BenGardiner/RAMN/docs/hardware/Fabrication/img/wrong_r.jpg

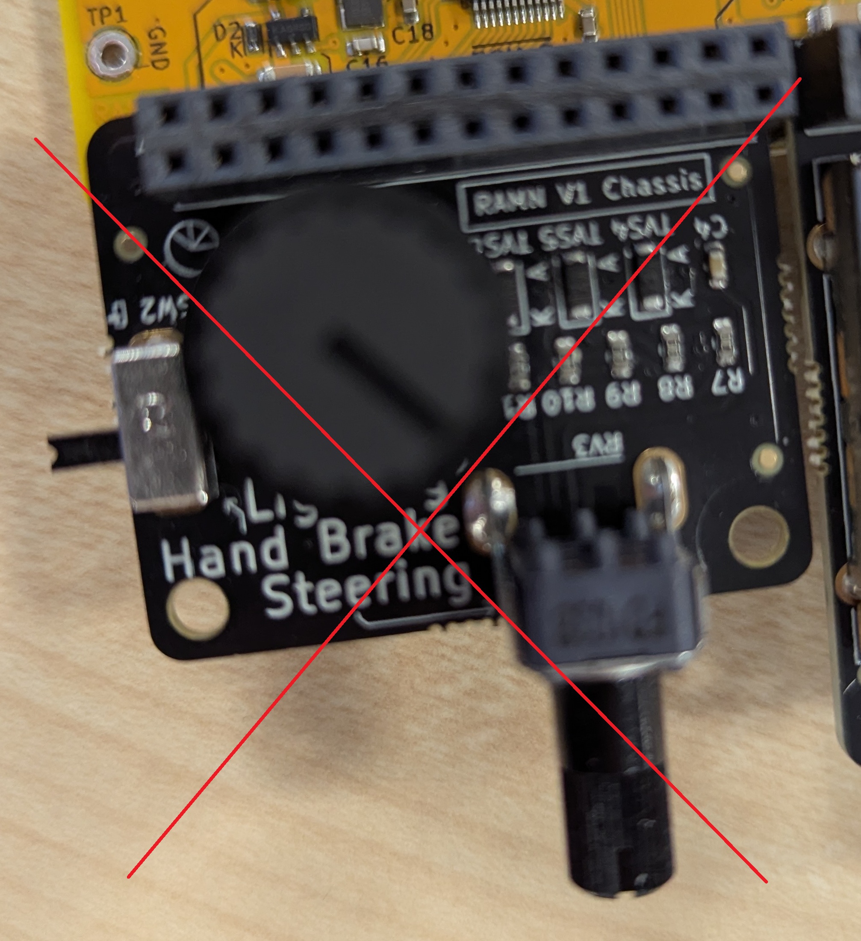
docs/hardware/Fabrication/img/wrong_r.jpg
