BenGardiner/RAMN/docs/hardware/Fabrication/img/correct_l.jpg

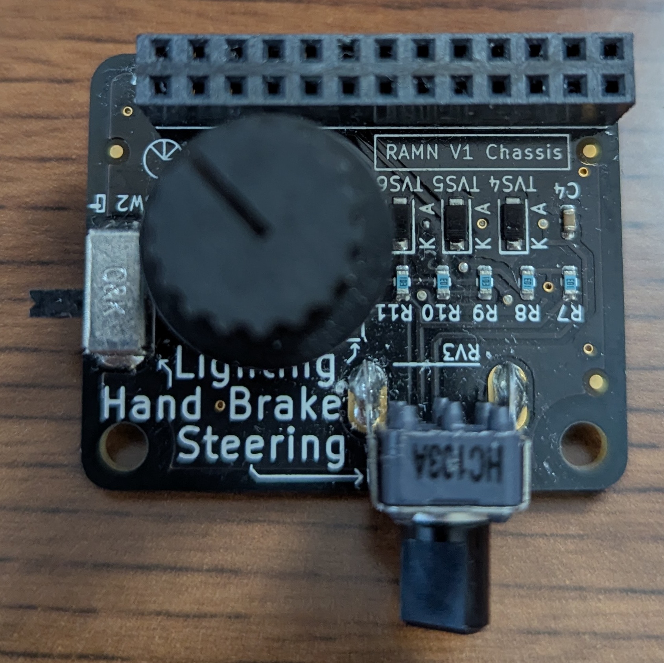
docs/hardware/Fabrication/img/correct_l.jpg
