BenGardiner/RAMN/docs/hardware/Fabrication/img/correct_o.jpg

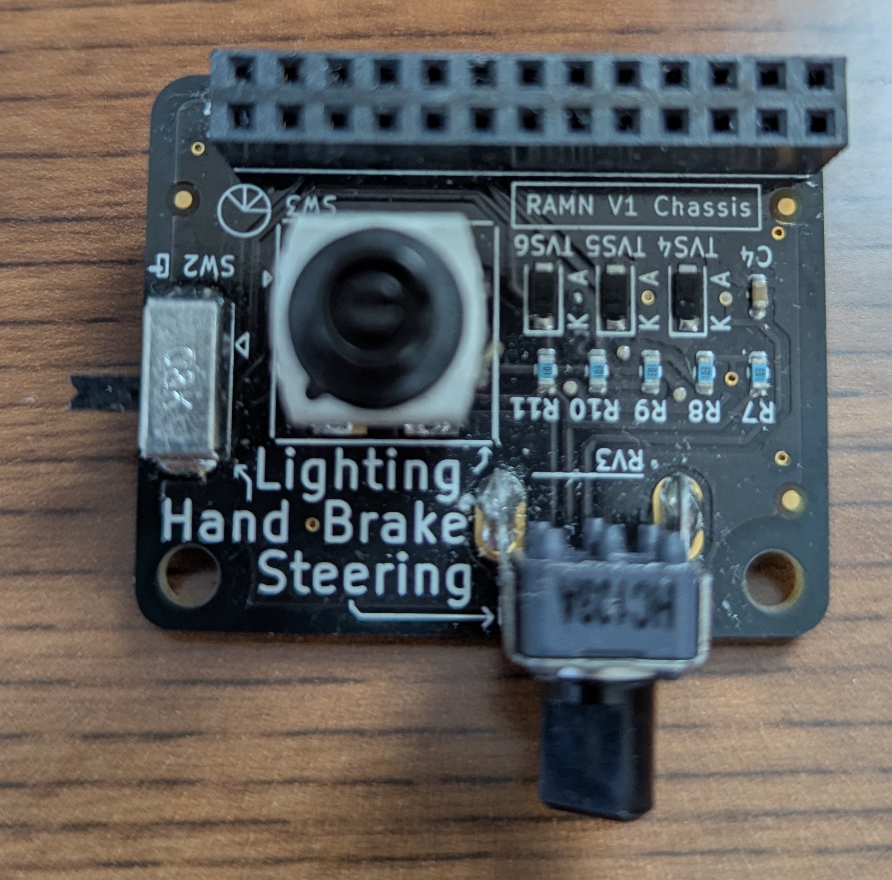
docs/hardware/Fabrication/img/correct_o.jpg
