BenGardiner/RAMN/docs/hardware/Fabrication/img/correct_r.jpg

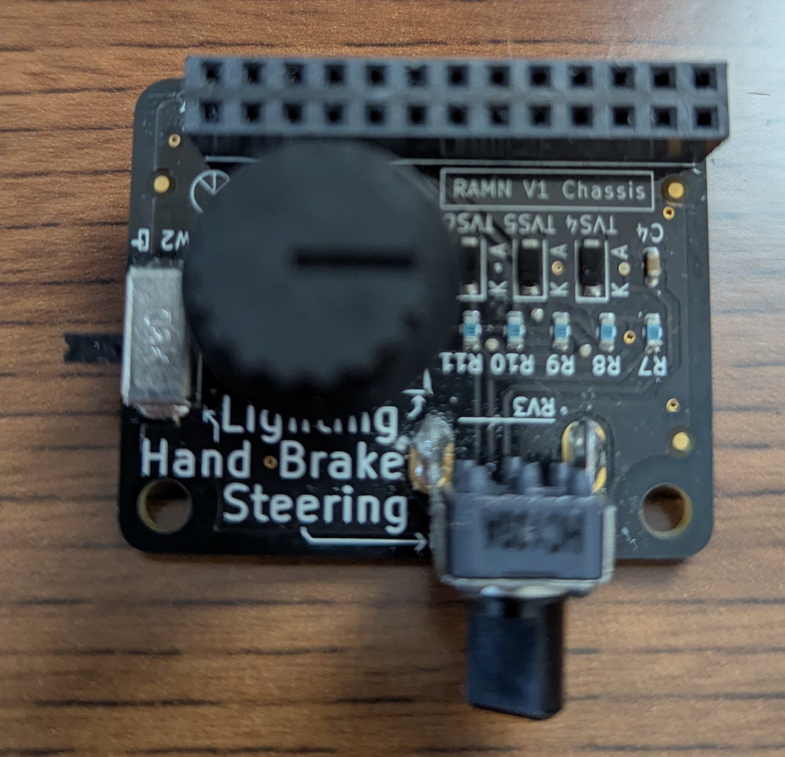
docs/hardware/Fabrication/img/correct_r.jpg
