BenGardiner/RAMN/docs/hardware/Fabrication/img/wrong_l.jpg

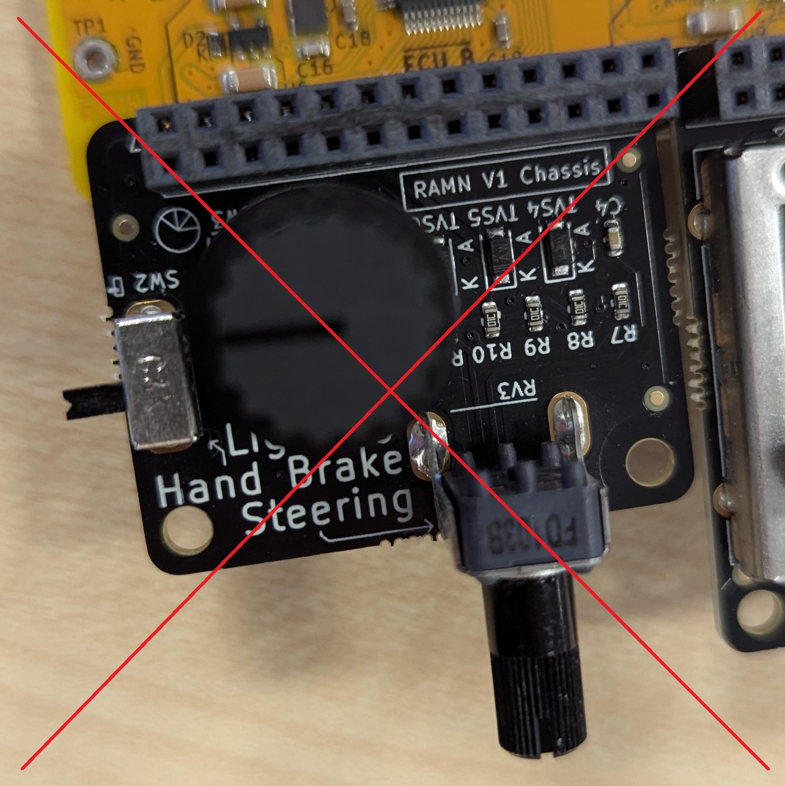
docs/hardware/Fabrication/img/wrong_l.jpg
