BenGardiner/RAMN/docs/hardware/Fabrication/img/wrong_o.jpg

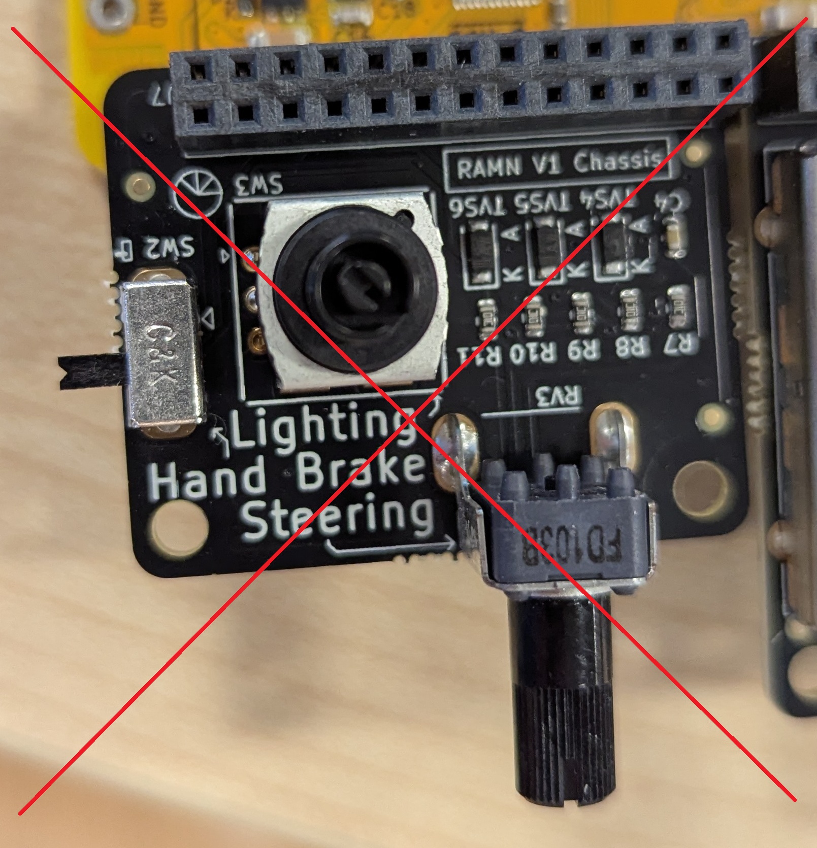
docs/hardware/Fabrication/img/wrong_o.jpg
