BenGardiner/RAMN/firmware/RAMNV1/Core/Inc/ramn_spi.h

/*
 * ramn_spi.h
  ******************************************************************************
  * @attention
  *
  * <h2><center>&copy; Copyright (c) 2025 TOYOTA MOTOR CORPORATION.
  * ALL RIGHTS RESERVED.</center></h2>
  *
  * This software component is licensed by TOYOTA MOTOR CORPORATION under BSD 3-Clause license,
  * the "License"; You may not use this file except in compliance with the
  * License. You may obtain a copy of the License at:
  *                        opensource.org/licenses/BSD-3-Clause
  *
  ******************************************************************************
 */

// This Module handles SPI communication, with the LCD Screen (ECU A) or the LEDs (ECU D)

#ifndef INC_RAMN_SPI_H_
#define INC_RAMN_SPI_H_

#include "main.h"
#include "cmsis_os.h"
#ifdef ENABLE_SCREEN
#include "fonts.h"
#include "ramn_usb.h"
#include "ramn_canfd.h"
#include "ramn_trng.h"

// Below are definitions for ST7789 Chipset screen
#define ST7789_CASET 0x2A
#define ST7789_RASET 0x2B
#define ST7789_MADCTL 0x36
#define ST7789_RAMWR 0x2C
#define ST7789_RAMRD 0x2E
#define ST7789_COLMOD 0x3A
#define ST7789_INVON  0x21
#define ST7789_SPLOUT 0x11
#define ST7789_SWRESET 0x01
#define ST7789_NORON 0x13
#define ST7789_DISPON 0x29
#define ST7789_RAMCTRL 0xB0
#define ST7789_SPI2EN 0xE7
#define ST7789_VSCRDEF 0x33
#define ST7789_VSCSAD 0x37

#define LCD_WIDTH 240
#define LCD_HEIGHT 240
//#define LCD_HEIGHT 320
#define SCROLL_WINDOW_HEIGHT 320 // Even 240x240 screens have a scrolling window of 320 pixels in RAM
#define SCREEN_HEADER_SIZE 32 // Size of header displayed when scrolling
#define SCREEN_FOOTER_SIZE 0 // Size of footer displayed when scrolling
#define SCROLL_AREA_SIZE (SCROLL_WINDOW_HEIGHT-(SCREEN_HEADER_SIZE+SCREEN_FOOTER_SIZE))

// Colors must be in RGB565 format.
#define COLOR_BLACK 0x0000
#define COLOR_WHITE 0xFFFF
#define COLOR_RED 0xF800
#define COLOR_GREEN 0x07E0
#define COLOR_BLUE 0x001F

#endif

#ifdef ENABLE_SPI

// Initializes the Module.
void 	RAMN_SPI_Init(SPI_HandleTypeDef* handler, osThreadId_t* pTask);

#endif

#ifdef ENABLE_SCREEN
// Initializes the screen and turn it ON.
void 	RAMN_SPI_InitScreen(void);

// Sets the current screen scroll.
void 	RAMN_SPI_SetScroll(uint16_t val);

// Increases the current screen scroll.
void 	RAMN_SPI_ScrollUp(uint16_t addVal);

// Draws the value of a specific pixel on the screen.
void 	RAMN_SPI_DrawPixel(uint16_t x, uint16_t y, uint16_t color);

// Draws a rectangle of the specified color on the screen.
void 	RAMN_SPI_DrawRectangle(uint16_t startx, uint16_t starty, uint16_t w, uint16_t h,uint16_t color);

// Draws a contour (empty rectangle).
void 	RAMN_SPI_DrawContour(uint16_t startx, uint16_t starty, uint16_t endx, uint16_t endy, uint16_t width, uint16_t color);

// Draws a 565 color image from specified array (Little Endian).
void 	RAMN_SPI_DrawImage(uint16_t x, uint16_t y, uint16_t w, uint16_t h, const uint8_t* image);

// Draws ONE character with specified background/foreground color.
void 	RAMN_SPI_DrawChar(uint16_t x, uint16_t y, uint16_t fgColor, uint16_t bgColor, uint8_t chr);

// Draws a character WITHOUT spacing (for overwriting a string, this function assumes the background is already drawn).
void 	RAMN_SPI_RefreshChar(uint16_t x, uint16_t y, uint16_t fgColor, uint16_t bgColor, uint8_t chr);

// Draws specified zero-terminated string with specified background/foreground color. \n and \r treated as newLines.
void 	RAMN_SPI_DrawString(uint16_t x, uint16_t y, uint16_t fgColor, uint16_t bgColor, const char* src);

// Same as RAMN_SPI_RefreshChar but with strings.
void 	RAMN_SPI_RefreshString(uint16_t x, uint16_t y, uint16_t fgColor, uint16_t bgColor, const char* src);

// Same as RAMN_SPI_DrawString/RAMN_SPI_RefreshString  but using uint32_t as argument. Displays in hex by default (without leading 0x)
void 	RAMN_SPI_DrawUint32(uint16_t x, uint16_t y, uint16_t fgColor, uint16_t bgColor, uint32_t val);
void 	RAMN_SPI_RefreshUint32(uint16_t x, uint16_t y, uint16_t fgColor, uint16_t bgColor, uint32_t val);



#endif

#if defined(EXPANSION_BODY) && defined(ENABLE_SPI)
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
