BenGardiner/RAMN/(commit log)

2025-11-12 clarified lighting switch orientation with pictures; updated documentation.
2026-02-28 Fix all compiler warnings across ECUA/B/C/D firmware targets (#3)
    * Fix all compiler warnings across ECUA, ECUB, ECUC, ECUD targets
    - ramn_j1979.c: Add #include <string.h> for memset/strcpy, initialize loop variable i
    - ramn_uds.c: Add #include <string.h> for strcpy/strcmp, fix incompatible pointer type cast, add (const uint8_t*) casts for FLAG macros
    - ramn_ctf.c: Add #include <string.h> for memcmp
    - ramn_spi.c: Move SPI DMA functions from ENABLE_SPI to ENABLE_SCREEN guard to avoid unused-function warnings
    - ramn_screen_canlog.c: Add explicit casts to resolve discarded volatile qualifier warnings
    - usbd_gs_usb.c: Move forward declaration and gscan_dconf inside #ifdef ENABLE_GSUSB
    Co-autho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
    [ramn_ctf.c, ramn_j1979.c, ramn_screen_canlog.c, ramn_spi.c, ramn_uds.c]
2026-02-28 Fix SLCAN TX interleaving: hold USB TX lock across ack + CAN send (#1)
    * Fix SLCAN write ordering bug: send '\r' ack before queuing CAN frame
    Move the '\r' acknowledgment to before RAMN_FDCAN_SendMessage() for both
    standard ID ('t'/'r') and extended ID ('T'/'R') transmit commands. This
    prevents a race condition where the CAN RX task could write a 't' start-of-frame
    before the '\r' ack from the transmit command, since RAMN_FDCAN_SendMessage
    queues the frame which may be received and forwarded by the CAN RX task
    before the USB ack is sent.
    Also consolidate the 'N' serial number response to include '\r' in a
    single atomic USB send, preventing similar interleaving.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
    [ramn_cdc.c, ramn_usb.c, ramn_usb.h]
2026-03-04 Fix STM32 HAL USB PCD concurrency bug by adding IRQ-safe critical sections
    Add HAL_NVIC_DisableIRQ(USB_FS_IRQn) / HAL_NVIC_EnableIRQ(USB_FS_IRQn) around
    __HAL_LOCK/__HAL_UNLOCK in HAL_PCD_EP_Receive() and HAL_PCD_EP_Transmit() to
    prevent USB interrupt preemption during endpoint configuration, which caused
    USBD_BUSY deadlocks on aggressive xHCI host controllers.
2026-03-04 Handle lock failure edge case: re-enable IRQ before returning HAL_BUSY
    Replace __HAL_LOCK/__HAL_UNLOCK macros with manual lock check to ensure
    HAL_NVIC_EnableIRQ is always called, even if the lock is already held.
2026-03-04 Move USB concurrency fix to usbd_conf.c with USER CODE block protection
    Revert stm32l5xx_hal_pcd.c to its original state since HAL driver files
    are overwritten by STM32CubeMX firmware package updates.
    Instead, apply the IRQ disable/enable protection at the application level
    in usbd_conf.c around HAL_PCD_EP_Transmit() and HAL_PCD_EP_Receive() calls,
    wrapped in USER CODE BEGIN/END block comments to survive CubeMX regeneration.
2026-03-04 Fix USB PCD concurrency: add __HAL_LOCK with IRQ critical sections in HAL driver
    Applies the proven fix from the ST community thread:
    - Add HAL_NVIC_DisableIRQ(USB_FS_IRQn) before __HAL_LOCK(hpcd)
    - Add HAL_NVIC_EnableIRQ(USB_FS_IRQn) after __HAL_UNLOCK(hpcd)
    in both HAL_PCD_EP_Receive() and HAL_PCD_EP_Transmit().
    Reverts previous incorrect approach that wrapped calls in usbd_conf.c.
    Changes marked with USER CODE BEGIN/END comments per CubeMX convention.
2026-03-05 Fix EP2 OUT descriptor: wMaxPacketSize 128->64 for Full-Speed USB compliance
    The OUT endpoint 2 descriptor used GSUSB_RX_DATA_SIZE (128 bytes) for
    wMaxPacketSize, which is invalid per USB 2.0 §5.8.3 (Full-Speed bulk
    endpoints must use 8, 16, 32, or 64 bytes). AMD xHCI controllers strictly
    enforce this and reject the device.
    Changed to CAN_DATA_MAX_PACKET_SIZE (64), matching the actual endpoint
    configuration in usbd_gs_usb.c which already opens EP2 OUT with 64 bytes.
    The GSUSB_RX_DATA_SIZE (128) is preserved for the receive buffer and
    PrepareReceive calls, which can safely exceed the endpoint max packet size.
2026-03-06 STALL unhandled USB control requests in composite Setup handler
    Return USBD_FAIL in USBD_Composite_Setup default case so that
    USBD_CtlError properly STALLs EP0 for unrecognized interface
    requests. Previously the handler silently returned USBD_OK without
    sending any USB response, causing Windows hosts to hang on
    enumeration (Code 43).
    This ensures protocol-compliant negative acknowledgment for:
    - Microsoft-specific vendor requests (URB_FUNCTION_GET_MS_FEATURE_DESCRIPTOR)
    - Any control request targeting an unknown interface index
2026-03-06 Port USB STALL and descriptor fixes from reference firmware
    Port changes from BenGardiner/ucan_cantact_fw commits 8611dd5 and
    7b36380 for Windows and AMD xHCI USB host compatibility:
    1. USBD_GSUSB_Setup: STALL unknown standard requests and request
    types instead of silently returning OK (separate SET_INTERFACE
    from default case)
    2. USBD_GSUSB_CustomDeviceRequest: STALL unmatched vendor code
    requests with USBD_CtlError instead of falling through to
    USBD_LL_SetupStage dispatch
    3. IAD bInterfaceCount: 0x02 → 0x01 (DFU has class 0xFE, not
    vendor-specific 0xFF, so must not be grouped with GS_USB)
    4. MS Compatible ID Feature Descriptor: remove DFU section,
    update length 0x40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
2026-03-06 Add WARNING comments for AMD xHCI USB compatibility
    Port documentation comments from reference commit 46dd094:
    - Device Qualifier Descriptor NULL callback hard-fault risk
    - IAD bInterfaceCount=1 requirement for AMD xHCI
    - EP2 wMaxPacketSize <=64 Full Speed bulk requirement
    - MS Compatible ID single WINUSB section requirement
    - STALL handlers required for Windows enumeration
    - Device class triad 0xEF/0x02/0x01 for IAD
    - Updated HAL PCD concurrency fix comment style
    - Config descriptor size breakdown comments
2026-03-06 Fix DFU interface Code 28 confusion in Device Manager
    The device showing Code 28 "no driver" in Windows Device Manager is the
    DFU interface (interface 1), NOT the gs_usb interface (interface 0).
    The gs_usb interface works correctly via WinUSB.
    - Rename DFU interface string: "RAMN gs_usb interface" → "RAMN DFU interface"
    so Device Manager clearly shows which interface has Code 28
    - Add WARNING comment explaining Code 28 is expected for the DFU runtime
    interface (Windows has no built-in DFU driver)
    - Fix bInterfaceClass comment: 0xFE is Application Specific (DFU), not
    Vendor Specific (0xFF)
    [ramn_config.h]
2026-03-06 Remove non-functional DFU interface to fix Windows Code 28 warning
    The DFU interface (interface 1) was a vestigial descriptor inherited from
    the candlelight gs_usb reference design. RAMN does not implement USB DFU
    protocol — it uses the STM32 bootloader via a CDC serial command instead.
    The non-functional DFU interface caused Code 28 "no driver" in Windows
    Device Manager.
    - Remove DFU interface descriptor and DFU functional descriptor (18 bytes)
    - Remove gsusb_dfu_request function and gsusb_vendor_request dispatcher
    - Remove DFU_INTERFACE_NUM, DFU_INTERFACE_STR_INDEX, dfu_detach_requested
    - Update descriptor sizes: 124→106 (CDC+GSUSB), 58→40 (GSUSB-only)
    - Update interface counts: 4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
    [ramn_config.h]
2026-03-06 Change USB product string from "RAMN USB Composite Device" to "RAMN gs_usb Device"
2026-03-06 build: be quiet unless there's a problem
    command line builds just print the 4x 'build done 0 errors, 0 warnings'
    lines (one for each ECU)
    CI builds are still noisy
2026-03-07 centralize and test the current signal serdes
2026-03-07 fix left and right turn signals
    [ramn_can_database.c, test_serdes_roundtrip.py]
2026-03-07 fix dump screen header ON/STOP alignment
    [ramn_screen_canlog.c]
2026-03-10 fix periods to be J1939 standards compliant (but as fast as possible)
    [ramn_vehicle_specific.h]
2026-03-16 Add J1939 CA scanner with multi-method detection tracking
    Create RAMN_J1939_Scanner.py implementing j1939_scan() that:
    - Probes CAN bus using four techniques (addr_claim, ecu_id, unicast, rts_probe)
    - Accumulates all detection methods per SA (never overwrites)
    - Returns sorted list of (sa, detections) tuples
    Add test_j1939_scanner.py with 11 tests validating scanner behavior.
2026-03-16 Add UDS (Tester Present) as 5th J1939 scan technique
    - Add PF_DIAG=0xDA constant and UDS_TESTER_PRESENT_REQ/RESP constants
    - Add _scan_uds() function that probes each DA with Tester Present
    (SID=0x3E) and records SAs that return positive response (0x7E)
    - Wire _scan_uds() into j1939_scan() as 5th technique
    - Update tests: TestAllFiveTechniquesOnAllECUs, TestUdsScanDetection,
    TestUdsScanner protocol tests
    - All 43 tests pass (15 scanner + 28 protocol)
2026-03-17 Fix UDS scan response matching and add rate limiting with bitrate extraction
    - Fix UDS scan to use prefix comparison (data[:3]) instead of exact match,
    so padded CAN frames (8-byte with 0xFF/0x00 padding) are detected
    - Add _inter_probe_delay() for rate-limiting per-DA scan loops
    - Add _get_bitrate() to extract bitrate from CANSocket/Bus objects
    - Wire rate limiting into unicast, rts_probe, and uds scan techniques
    - Add bitrate/busload parameters to j1939_scan() public API
    - When bitrate=None, scanner reads sock.bitrate; falls back to 250000
    - Add tests for padded UDS responses, rate-limiting, bitrate extraction
    [RAMN_J1939_Scanner.py, test_j1939_scanner.py]
2026-03-17 Extract CAN_FRAME_OVERHEAD_BITS constant from magic number 47
    Replace magic number 47 in _inter_probe_delay() with named constant
    CAN_FRAME_OVERHEAD_BITS for self-documenting rate-limit calculation.
    [RAMN_J1939_Scanner.py]
2026-03-22 fix warnings in bitbanging stuff
    [ramn_bitbang.c, ramn_cdc.c]
2026-03-22 Add compile-time forced autopilot/fuzzer mode and safe program_BCD scripts
    - Add RAMN_FORCE_AUTOPILOT macro to ramn_config.h (commented out by default)
    - Add forced autopilot code path in ramn_simulator.c that randomizes
    command/control values at 1 Hz using TRNG, bypassing sensor overrides
    - Include ramn_trng.h conditionally in ramn_simulator.h
    - Add disable_autopilot.py helper script for safe flashing
    - Update ProgramECU_BCD.sh and .bat to disable autopilot before flashing
2026-04-08 add macro guards for variant build compatibility
    - ramn_config.h: Replace UART+CDC #error with #undef ENABLE_UART
    (auto-disable UART when CDC is active on ECU A)
    - ramn_config.h: Add KWP/XCP buffer sizes for ECU A behind
    ENABLE_KWP/ENABLE_XCP guards
    - main.c: Fix KWP TX buffer using wrong size macro
    (KWP_ISOTP_RX_BUFFER_SIZE -> KWP_ISOTP_TX_BUFFER_SIZE)
    - ramn_spi.c/h, ramn_actuators.c: Add ENABLE_SPI guard to
    RAMN_SPI_UpdateLED definition and call sites
    Agent-Logs-Url: https://github.com/BenGardiner/RAMN/sessions/1f1ef303-fbc5-4893-a129-e76bc35aebae
    [main.c, ramn_actuators.c, ramn_config.h, ramn_spi.c, ramn_spi.h]
2026-04-08 fix KWP_TX_CANID typo and reduce ECU A KWP buffer sizes
    - ramn_vehicle_specific.h: Fix typo KWP_TX_CANID referencing itself
    instead of KWP_RX_CANID for ECU A
    - ramn_config.h: Use smaller KWP buffer sizes for ECU A (0xFFF+2)
    to match UDS buffer pattern and fit in available RAM
    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
    [ramn_vehicle_specific.h]
2026-04-08 uart variant: disable CDC+USB instead of #undef UART, restore #error
    The uart variant now disables ENABLE_CDC and ENABLE_USB rather than
    silently undefining ENABLE_UART. The original #error for UART+CDC
    conflict is restored in ramn_config.h.
    Agent-Logs-Url: https://github.com/BenGardiner/RAMN/sessions/903e16fd-21c8-4ff7-a0f2-56a7d76238ed
    [ramn_config.h]
2026-04-08 reduce ECU A KWP buffer sizes to 0xFFF+2 to fix INSECURE_RAM overflow
    Agent-Logs-Url: https://github.com/BenGardiner/RAMN/sessions/3a274ba1-e0a1-4176-b9ae-4be7307cdbdf
    [ramn_config.h]
2026-04-11 Add SUMP/OLS logic analyzer mode for CAN TX/RX pin monitoring via PulseView
    - Create ramn_sump.h with SUMP protocol constants and API
    - Create ramn_sump.c with full SUMP state machine, GPIO sampling, and command processing
    - Add ENABLE_SUMP_OLS macro to ramn_config.h (enabled for ECU A)
    - Add 'sump' CLI command to ramn_cdc.c
    - Add SUMP help text to CLI help
    - Add config validation (requires ENABLE_BITBANG and ENABLE_CDC)
    - Add sump_ols variant to build workflow matrix
    Agent-Logs-Url: https://github.com/BenGardiner/RAMN/sessions/7243963c-7631-4e38-924f-61c9f24b834b
2026-04-11 Add SUMP protocol unit tests (57 tests, all passing)
    Test coverage includes:
    - Protocol constants validation
    - ID and metadata response format
    - Reset, divider, count, flags commands
    - Trigger mask/value for all 4 stages
    - ESC exit mechanism
    - Sample format for CAN TX/RX pins
    - PulseView handshake sequence simulation
    - Config guard verification
    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
    [test_sump_protocol.py]
2026-04-11 Fix SUMP enter loop drain logic, remove unused variable
    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
    [ramn_sump.c]
2026-04-11 SUMP auto-detect from PulseView + bitbang capture integration + tests
    Major changes:
    - SUMP_RUN now returns pre-recorded bitbang samples instead of live capture
    - All bitbang operations (Read, Dump, Send, Jam, LoopOF, DenyOnce) record TX+RX
    pin samples into shared SUMP buffer via RAMN_SUMP_RecordSample()
    - CDC ISR forwards binary control bytes (< 0x20) immediately when buffer is empty
    - SLCAN handler auto-detects SUMP_ID (0x02) probe and enters SUMP mode
    - 82 unit tests (25 new) covering auto-detect, capture, CDC forwarding
    Agent-Logs-Url: https://github.com/BenGardiner/RAMN/sessions/52ac2678-d68a-4b76-99bc-8fbc92b07436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
    [test_sump_protocol.py]
2026-04-11 Add SUMP pre/post trigger windowing, circular buffer, and trigger channel
    - Convert sample buffer to circular (power-of-2 masked) for continuous capture
    - Add RAMN_SUMP_TriggerIndex to track bitbang trigger position
    - Add SUMP_BIT_TRIG (bit 2) as channel 2 visible in PulseView
    - Add RAMN_SUMP_MarkTrigger() / BB_SUMP_MARK_TRIGGER() macro
    - Window SUMP_RUN output around trigger using SUMP CNT delay_count
    - Add BB_SUMP_MARK_TRIGGER() after successful Trigger() in all bitbang ops
    - Increase SUMP_NUM_PROBES to 3 (TX, RX, TRIG)
    - 97 tests pass (15 new tests for windowing, trigger, circular buffer)
    Agent-Logs-Url: https://github.com/BenGardiner/RAMN/sessions/0f0257f3-8c36-45ed-98c4-f6561a5d5826
    C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
2026-04-11 Add SUMP/OLS logic analyzer documentation to bitbang section
    Document entry (CLI 'sump' command and PulseView auto-detection),
    3-channel capture (CAN_TX, CAN_RX, TRIG), typical workflow with bb
    commands, pre/post trigger windowing, and clean ESC exit mechanism.
    Agent-Logs-Url: https://github.com/BenGardiner/RAMN/sessions/7642e56a-da5b-479c-aaa7-224568b9471b
2026-04-11 Add bb gsusb command: GS_USB + bitbang bridge mode
    Implements a new 'bb gsusb' CLI command that bridges the GS_USB
    (candlelight) interface with the bitbang module. CAN frames received
    via bitbang are delivered to the host through GS_USB, and frames sent
    by the host are transmitted using GPIO bitbanging.
    Includes:
    - BB_BuildFrameBitstream(): builds complete CAN frame with stuffing/CRC
    - BB_ParseFrameFields(): extracts frame fields from destuffed capture
    - RAMN_BITBANG_GsUsbLoop(): main bridge loop with ESC exit
    - Documentation in protocol_tutorial.rst
    Agent-Logs-Url: https://github.com/BenGardiner/RAMN/sessions/6490a94d-b88c-4b3b-adc7-947176e46262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
2026-04-11 Add RAMN_GSUSB_BBMode flag: GS_USB only uses bb after CLI command
    The FDCAN RX callback in main.c now checks RAMN_GSUSB_BBMode before
    forwarding frames to GS_USB. The flag is False by default (normal
    FDCAN-based GS_USB operations). The 'bb gsusb' CLI command sets it
    before BB_Start() and clears it after BB_Stop(), ensuring clean
    transitions between normal and bb modes.
    Agent-Logs-Url: https://github.com/BenGardiner/RAMN/sessions/683d17c4-b35c-4c99-8b22-1abb8a850349
2026-04-11 Preserve bb mode on ESC exit from bb gsusb loop
    ESC now exits the active bitbang+GS_USB loop but does NOT clear
    RAMN_GSUSB_BBMode. The flag persists so FDCAN RX is not forwarded
    to GS_USB after exiting. The user can re-enter 'bb gsusb' to
    resume the bridge.
    Agent-Logs-Url: https://github.com/BenGardiner/RAMN/sessions/a0db99b4-56f7-48c6-9d00-43674b329d0c
2026-04-11 Revert 'Preserve bb mode on ESC exit from bb gsusb loop'
    Restores RAMN_GSUSB_BBMode = False on ESC exit so normal GS_USB
    operations resume when leaving the bb gsusb loop.
    Agent-Logs-Url: https://github.com/BenGardiner/RAMN/sessions/97dab172-332c-4b4e-a058-78f2d220f83c
    [ramn_bitbang.c, ramn_gsusb.h]
2026-04-11 Document user flow: bitbang, SUMP, and GS_USB combined workflow
    Add 'Combined Workflow' section to protocol_tutorial.rst documenting:
    - GS_USB behavior at each stage (normal, bb commands, bb gsusb, sump)
    - Full iterative debugging workflow (trigger → capture → PulseView → repeat)
    - GS_USB bridge workflow with SUMP
    - Clarify RAMN_GSUSB_BBMode lifecycle in header comment
    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
2026-04-11 Add SUMP auto-enter from bb gsusb mode (PulseView 0x02 probe detection)
    When in bb gsusb mode, RAMN now detects PulseView's SUMP probe byte
    (0x02) in the USB stream. On detection, the bb gsusb loop pauses,
    enters SUMP mode to serve pre-recorded samples, and resumes when
    SUMP exits (ESC). ESC outside SUMP still exits bb gsusb entirely.
    New BB_CheckForEscOrSUMP() function returns a tri-state result
    (NONE/ESC/SUMP) to support both behaviors in the same loop.
    Guarded by ENABLE_SUMP_OLS && ENABLE_GSUSB.
    Agent-Logs-Url: https://github.com/BenGardiner/RAMN/sessions/14d131c5-9a46-4339-b20c-e40bb7e06cd8
2026-04-11 SUMP: auto-capture on RUN, RLE compression with 1M window, CLI auto-detect
    1. SUMP_RUN auto-captures (calls RAMN_BITBANG_Read) when no samples exist
    2. RLE compression: report 1M window to PulseView, compress identical
    consecutive samples with SUMP RLE encoding when SUMP_FLAG_RLE is set
    3. SUMP auto-detect (PulseView 0x02 probe) now works in CLI mode too,
    not just SLCAN mode - added check in RAMN_CDC_ProcessCLIBuffer
    4. FLAGS handler now parses all 4 parameter bytes (needed for RLE bit 8)
    5. Updated tests: 116 tests (was 97), all passing
    Agent-Logs-Url: https://github.com/BenGardiner/RAMN/sessions/514bba00-aa80-4b1a-ad99-0d5b73c947f8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
2026-04-11 fix: use silent bitbang capture for SUMP auto-capture (no USB text)
    SUMP_RUN now calls RAMN_BITBANG_ReadSilent() instead of RAMN_BITBANG_Read()
    when auto-capturing on first PulseView run. The silent version captures
    samples into the SUMP buffer without sending any human-readable text
    (Raw/Destuffed/CAN annotations) to USB, which was corrupting PulseView's
    binary SUMP data stream and causing no samples to be visible.
    Agent-Logs-Url: https://github.com/BenGardiner/RAMN/sessions/f6a18ca6-ede4-45ca-830c-f6269dc7c807
    [ramn_bitbang.c, ramn_bitbang.h, ramn_sump.c, test_sump_protocol.py]
2026-04-11 fix: SUMP CDC raw forwarding, remove dangerous auto-capture, fix delay_count +1
    Root cause: CDC ISR only forwarded control bytes (<0x20) as SUMP commands.
    PulseView's binary long commands (FLAGS 0x82, CNT 0x81, trigger 0xC0+)
    got stuck in the CDC line buffer since they're >=0x20 and no \r follows.
    Fix: Add RAMN_SUMP_Active flag checked by CDC ISR. When True (inside
    SUMP_Enter), ALL received USB bytes are forwarded raw to the stream
    buffer, bypassing line-buffering entirely. This lets PulseView's full
    command sequence (config + RUN) reach the SUMP state machine.
    Also:
    - Remove ReadSilent auto-capture from SUMP_RUN: it blocked with IRQs
    disabled and could hang forever after bb jam (BB_Wait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
    [ramn_bitbang.c, ramn_bitbang.h, ramn_sump.c, ramn_sump.h, test_sump_protocol.py]
2026-04-11 fix: SUMP sample width respects FLAGS channel group mask for PulseView compatibility
    PulseView disables channel groups 2-4 via SUMP FLAGS for 3-channel devices,
    expecting 1-byte-per-sample output. Previously we always sent 4 bytes per
    sample, causing PulseView to misinterpret data ("no data" visible).
    Changes:
    - Add sample_width to SUMP_Config_t, computed from FLAGS channel group bits
    - SUMP_EmitSample sends only sample_width bytes (1-4) per sample
    - SUMP_EmitRLECount uses sample_width bytes with correct max count
    - RLE encoding splits counts at sample_width-dependent maximum
    (127 for 1-byte, 32767 for 2-byte, etc.)
    - Add SUMP_FLAG_CHANGRP_1-4 constants to ramn_sump.h
    - Add 14 new tests f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
    [ramn_sump.c, ramn_sump.h, test_sump_protocol.py]
2026-04-11 fix: handle OLS separate read/delay count commands 0x83/0x84
    The sigrok OLS driver sends SUMP_READCOUNT (0x84) and SUMP_DELAYCOUNT
    (0x83) as separate commands instead of the combined SUMP_CNT (0x81).
    Without handling these, read_count and delay_count stayed at their huge
    defaults (1M), causing the firmware to send far more samples than
    PulseView expected — resulting in timeout and "no data" displayed.
    - Add SUMP_READCOUNT (0x84) and SUMP_DELAYCOUNT (0x83) constants
    - Handle both in SUMP_ProcessCommand with same encoding as SUMP_CNT
    - Add 10 new tests including sigrok-cli exact sequence reproduction
    - All 144 tests pass, firmware builds clean (0 errors, 0 warnings)
    Agent-Logs-Url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
    [ramn_sump.c, ramn_sump.h, test_sump_protocol.py]
2026-04-12 fix: bb vcd uses all available samples and compact one-line header
    The previous implementation ended the VCD window at the trigger point,
    but most bitbang commands (like denyonce) record the trigger marker
    before the interesting data. This meant the VCD showed zero signal
    changes.
    Now the VCD uses all available samples in the circular buffer (up to
    4096), giving the maximum possible window. The header is also emitted
    as a single line for maximum compactness.
    Agent-Logs-Url: https://github.com/BenGardiner/RAMN/sessions/45e44c42-e801-4637-b9ce-0f39b626164e
    [ramn_bitbang.c, ramn_bitbang.h]
2026-04-13 fix: SUMP ISR race condition and send error detection
    When PulseView sends SUMP commands batched in the same USB packet
    as the SUMP_ID probe (0x02), long commands (FLAGS 0x82, CNT 0x81)
    would get stuck in the CDC line buffer because they are >= 0x20.
    Fix: When SUMP_ID is detected in the CDC ISR, immediately set
    RAMN_SUMP_Active=True and forward all remaining bytes in the
    current USB packet raw. This ensures long SUMP commands reach
    the SUMP processor regardless of USB packet batching.
    Also add send error detection in SUMP send helpers so the device
    aborts quickly if the USB host disconnects mid-transfer instead
    of blocking for 2s per failed xStreamBufferSend call."
    Agent-Logs-Url: https:/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
    [ramn_sump.c]
2026-04-13 fix: flush USB TX pipeline on SUMP session boundaries to prevent stale data de-sync
    When the serial port is closed while CLI output (e.g. "Denying..." from
    bb denyonce) or SUMP sample data is still in the USB TX pipeline, stale
    bytes can survive in the USB PMA endpoint buffer. When sigrok-cli reopens
    the port and sends SUMP_ID, it reads these stale bytes instead of "1ALS",
    causing "Invalid reply" errors.
    Fix:
    - Add RAMN_USB_FlushTxPipeline() which suspends the TX task, resets the
    TX stream buffer, then resumes the TX task.
    - Call it on every SUMP_RESET and SUMP_ID, and before the initial "1ALS"
    response in all auto-detect paths (CLI, SLCAN, gsusb).
    - In SerialCloseCallback, NAK the CDC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
    [ramn_bitbang.c, ramn_cdc.c, ramn_sump.c, ramn_usb.c, ramn_usb.h]
2026-04-15 feat: RLE-compressed SUMP storage with dynamic metadata for sample count and rate
    Agent-Logs-Url: https://github.com/BenGardiner/RAMN/sessions/7520d072-d3de-4176-ac10-54d580c3afc9
2026-04-15 fix: VCD uses stored sample rate, bb gsusb accumulates SUMP samples across session, VCD emits final timestamp
    Agent-Logs-Url: https://github.com/BenGardiner/RAMN/sessions/9e5cb2a0-8f5c-4a22-adf9-4e804994df32
    [ramn_bitbang.c]
2026-08-14 ECUA: Add transport selection config, serial command abstraction, and LPUART1 backend
    - Add RAMN_SERIAL_CMD_TRANSPORT_USB_CDC / RAMN_SERIAL_CMD_TRANSPORT_LPUART1
    macros with compile-time XOR enforcement in ramn_config.h
    - Create ramn_serial_cmd.h/.c: transport-agnostic send API with backend
    function table registration
    - Refactor ramn_cdc.c to use RAMN_Serial_Send* instead of RAMN_USB_Send*
    - Extend ramn_cdc.h/.c guards to compile for both CDC and UART transports
    - Add UART lock/ASCII send functions to ramn_uart.h/.c for LPUART1 backend
    - Update main.c: register serial backends, route LPUART1 commands through
    CLI/sLCAN processors, extend CAN forwarding to both transports
    - Provide RAMN_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
