BenGardiner/RAMN/(notices)

Notices in the files:
firmware/RAMNV1/Core/Src/main.c:
© Copyright (c) 2021 STMicroelectronics.
All rights reserved.
This software component is licensed by ST under BSD 3-Clause license,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
